ImmanuelFH/Alarm-Clock-STM-32F/README.md

# Alarm-Clock-STM-32F
light-based alarm displaying a real time clock on 4-digit 7-segment LED display that receive inputs from push button to set time &amp; alarm, snooze and &amp; turn off
