ImmanuelFH/Alarm-Clock-STM-32F/(commit log)

2023-05-27 Create PCB file
2023-05-27 Create PCB
